jacksoniverson-ui/claude-code/stroker-desk-mount/README.md

# Stroker desk mount

A manual mount (no motor) that clamps to a desk edge and holds a caseless sleeve-style
stroker hands-free. The pivot has 15° steps, so you can angle it.

**Measured sleeve (2026-09-26): 125 mm long, 65 × 60 mm oval.** The cradle is now built in
Blender (`blender/build_cradle.py`) as an oval tube. It has no waist, so the lip-in-waist retention below
doesn't apply. The bore is 1 mm under the sleeve on both axes (64 × 59), so the sleeve
is held by squeeze, and a 6 mm lip at the back stops it being pushed through. Load it from the front.
The entrance sticks out 10 mm. The clamp, knobs and pad still come from the .scad and are unchanged.

**Print on the P1S:** open `stroker_mount_P1S_PETG.3mf`. All five parts are on one plate.
It is set up for PETG with 4 walls and 35% gyroid, with tree supports on the cradle only (under the pivot boss).
The Studio CLI slice passes: about 11 h 50 min and 256 g.
To rebuild after changing the sleeve size:

```sh
blender -b -P blender/build_cradle.py -- --len 125 --w 65 --h 60 --squeeze 1.0
blender -b -P blender/prepare_plate.py
python3 blender/make_p1s_3mf.py     # needs the canopy repo's 3mf writer; edit the paths at the top
```

*The round-sleeve notes below are for the original round-cradle .scad design.*

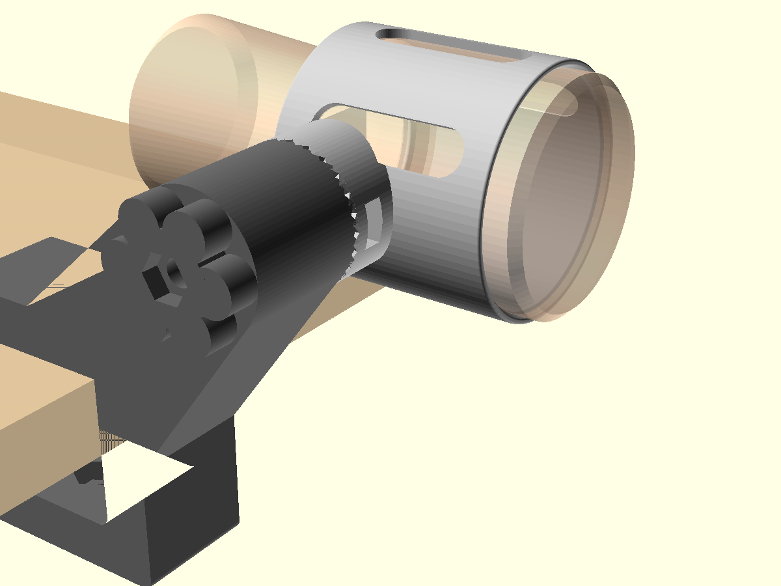
[picture p1: stroker-desk-mount/assembly.png]
assembly


## How it holds the sleeve

The sleeve has a wide front section, a narrow waist, then a flared rear. The **cradle** is a
tube that grips the wide section. A lip at the back of the tube sits in the waist:

- Pushing in drives the wide section's shoulder against the lip, so the sleeve can't be pushed through.
- Pulling out is stopped by the rear flare, which catches on the back of the lip.

To load it, squeeze the rear flare and push it through the lip from the front.
The slots let water drain and make it easier to clean.

## Parts

| File | Qty | Print orientation |
|---|-----|---|
| `clamp.stl`  | 1 | On its flat side, with the teeth facing up |
| `cradle.stl` | 1 | Standing on the lip end, with the tube upright |
| `knob.stl` | 2 | With the hex pocket facing up |
| `pad.stl` | 1 | Flat side down (optional; stick felt or rubber on it) |

Use PETG or ABS/ASA with 4+ perimeters and 30–40% infill for the clamp and cradle.
PLA works, but it creeps under constant clamping load and softens in hot water.

**Hardware:** 2× M8×60 hex bolts and 2× M8 hex nuts.

## Assembly

1. Press an M8 bolt head into each knob; a drop of CA glue holds it.
2. **Clamp screw:** drop a nut into the hex pocket inside the lower jaw. Thread a knob-bolt up
   through it from below and put the pad on the tip.
3. **Pivot:** slide a nut into the slot in the cradle boss. Mesh the cradle's teeth with the
   clamp's teeth, then pass the second knob-bolt through the clamp ear into that nut.
   To change the angle, loosen the knob, rotate the cradle, and tighten again.

## Fitting it to your sleeve (important)

The default numbers are estimates from the photos. Measure yours with calipers, or wrap a paper strip around it and divide the length by π.
Then edit the top of `stroker_desk_mount.scad`:

| Parameter  | What to measure | Default |
|---|---|---|
| `body_d` | Diameter of the wide section | 72 |
| `body_len` | Entrance face to where the waist starts | 75 |
| `waist_d`  | Diameter at the narrowest part of the waist | 55 |
| `squeeze`  | How much tighter the bore is than `body_d` | 1.0 |
| `desk_max` | Thickest desk the clamp should fit | 50 |
| `pivot_up` | Pivot height above the desktop (use a negative number to mount it under the edge) | 45 |

Before printing the full cradle, print a test ring. Set `wall = 1.6` and shorten `body_len`.

Export each part:

```sh
for p in clamp cradle knob pad; do
  openscad -D "part=\"$p\"" -o $p.stl stroker_desk_mount.scad
done
```

## Blender → Bambu Studio

`blender/prepare_plate.py` takes the STLs into Blender. It:
- repairs the meshes and checks that they are watertight,
- turns each part to its print orientation,
- lays all the parts out on a 256 mm Bambu bed (X1/P1/A1),
- exports **`stroker_mount_plate.3mf`**.

```sh
blender -b -P blender/prepare_plate.py   # re-run after changing the .scad and re-exporting the STLs
```

To print, open `stroker_mount_plate.3mf` in Bambu Studio (File → Import, or drag it in).
Then choose your printer and PETG, slice, and press **Print** to send it to the printer.
You can also send it from Bambu Handy.

Suggested slicer settings:
- 4 walls
- 35% gyroid infill
- No supports, except "tree, touching build plate" if the preview shows the cradle boss sagging

The whole plate is 256 × 197 mm. For an A1 mini, set `BED = 180` in the script; it will then refuse to build the plate,
so print the cradle and clamp as separate plates.
