jacksoniverson-ui/claude-code/stroker-desk-mount/blender/plate.png

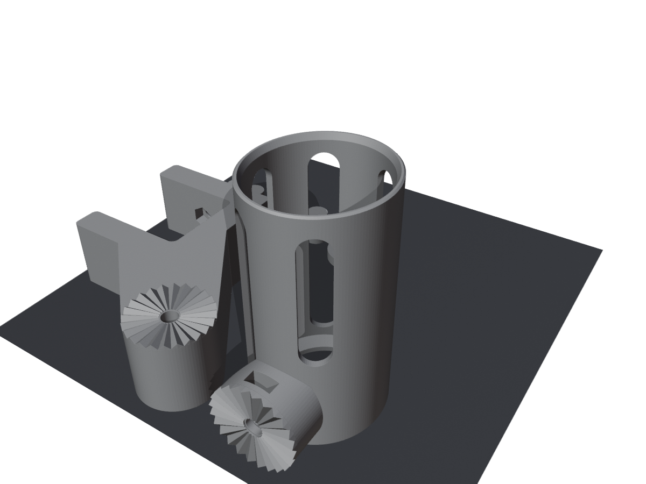
stroker-desk-mount/blender/plate.png
