jacksoniverson-ui/claude-code/stroker-desk-mount/cradle.stl

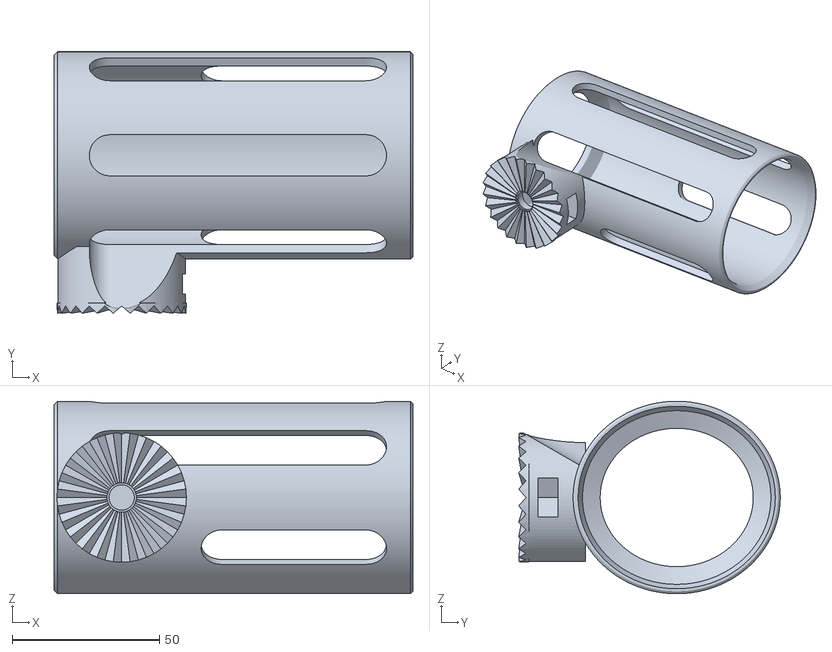
[picture p3: CAD file, 2026-09-26]
stroker-desk-mount/cradle.stl
122.0 x 88.9 x 65.4
