jacksoniverson-ui/claude-code/stroker-desk-mount/stroker_mount_P1S_PETG.3mf

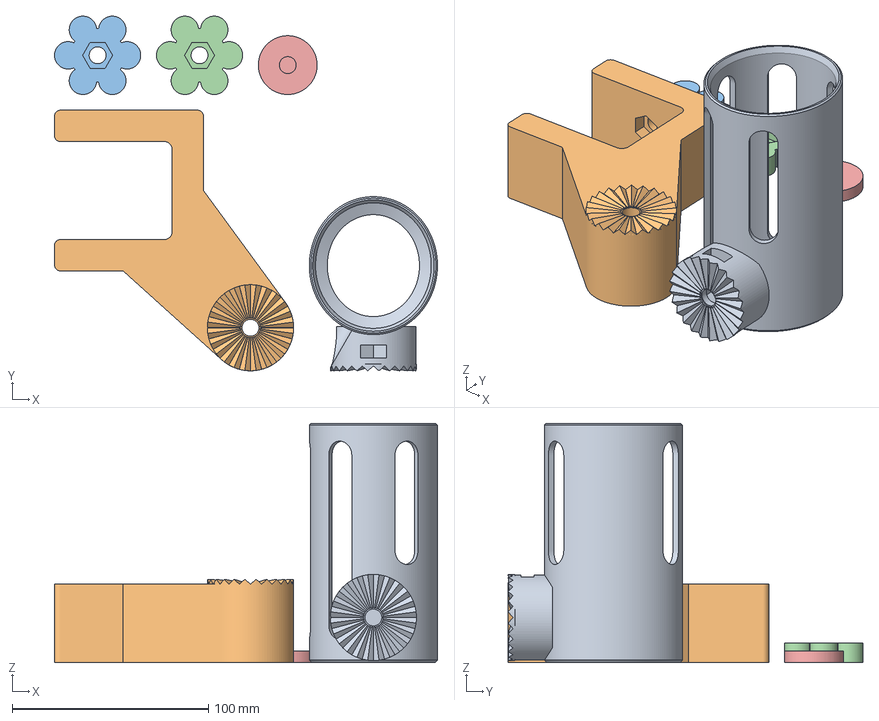
[picture p4: CAD file, 2026-09-26]
stroker-desk-mount/stroker_mount_P1S_PETG.3mf
195.4 x 181.0 x 122.0 mm
cradle
clamp
knob
knob.2
