jacksoniverson-ui/claude-code/stroker-desk-mount/pad.stl

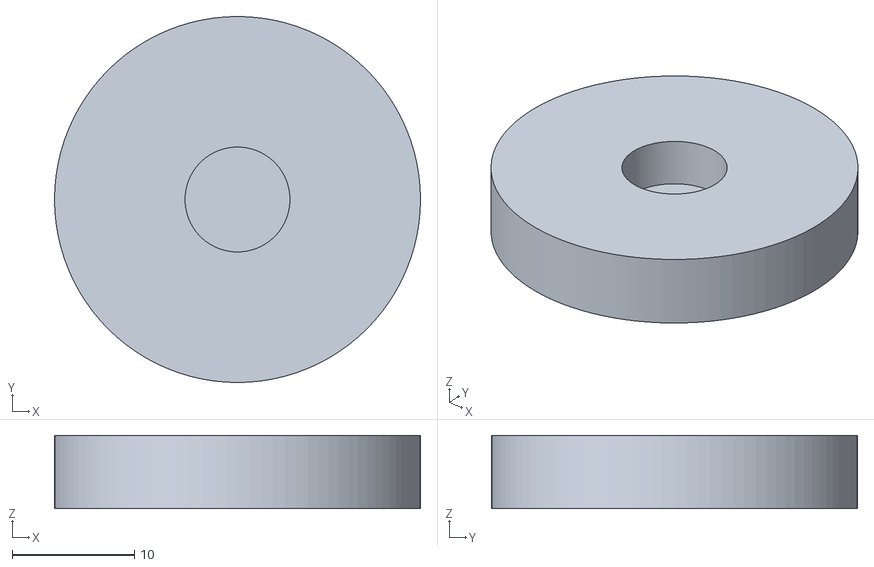
[picture p5: CAD file, 2026-09-26]
stroker-desk-mount/pad.stl
30.0 x 30.0 x 6.00
