jacksoniverson-ui/claude-code/stroker-desk-mount/clamp.stl

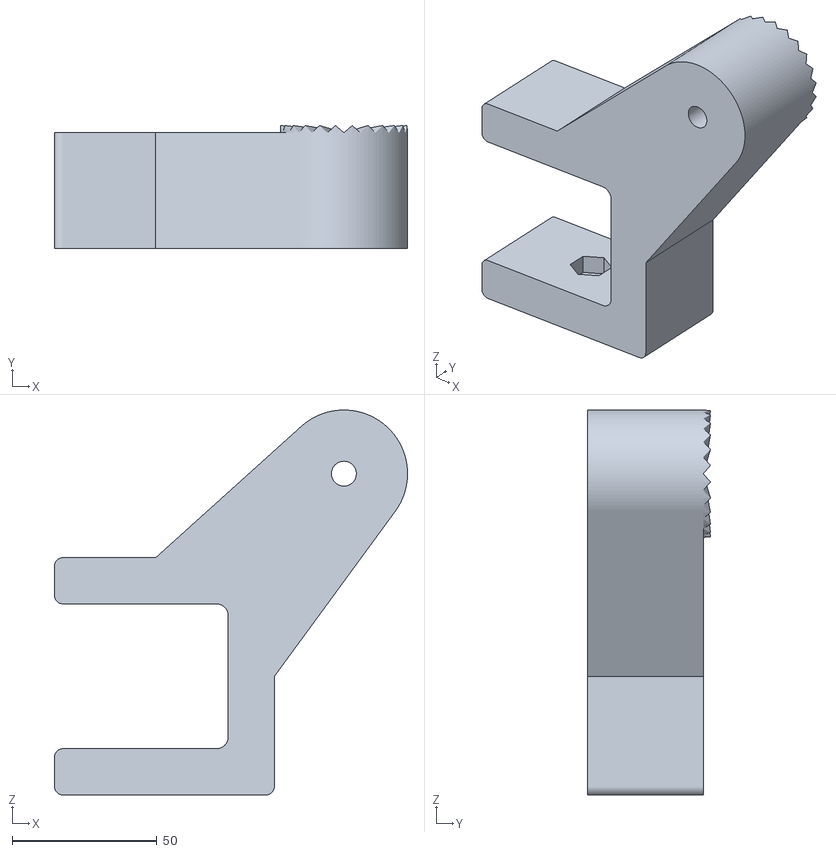
[picture p6: CAD file, 2026-09-26]
stroker-desk-mount/clamp.stl
122.0 x 42.5 x 133.0
