jacksoniverson-ui/claude-code/stroker-desk-mount/knob.stl

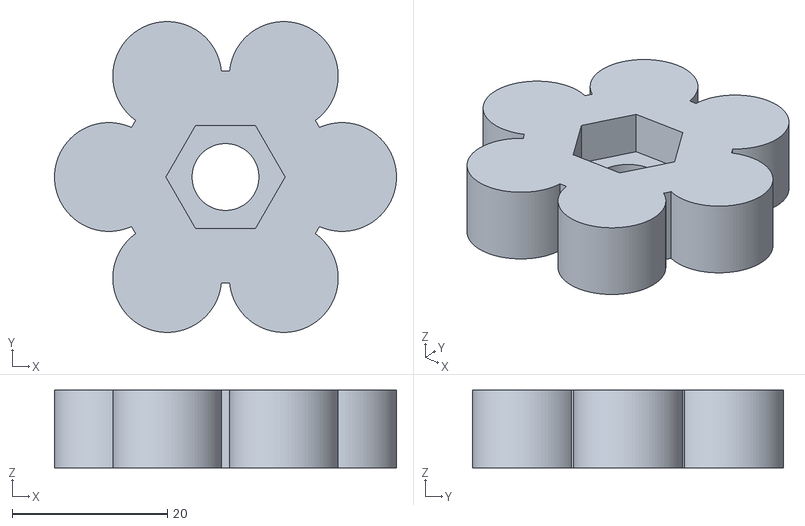
[picture p7: CAD file, 2026-09-26]
stroker-desk-mount/knob.stl
44.0 x 40.0 x 10.0
