jacksoniverson-ui/claude-code/(list of files, cad)

Other CAD files:
stroker-desk-mount/stroker_mount_plate.3mf
stroker-desk-mount/blender/stroker_mount.blend
