jacksoniverson-ui/claude-code/(commit log)

2026-09-01 Add Canopy trim room inventory tracking
    Tracks material through the trim room across four streams — A buds, B buds,
    trim and waste — so every gram weighed into a batch can be accounted for at
    the end of the shift.
    Flow: weigh a batch in, issue material to a trimmer's station, weigh out to a
    stream, weigh whatever is left back to the batch when the station closes. Per
    station, accounted = A + B + trim + waste + returned, and variance is that
    against the weight issued; a batch's variance is the sum of its stations'.
    Anything past the configurable tolerance (default 2%) is flagged in the room,
    the reports and the exports.
    Guardrails that matter for compliance:
    - Stations cannot be issued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
2026-09-26 Add parametric 3D-printable desk mount for a sleeve stroker
    OpenSCAD source plus rendered STLs: desk C-clamp with an adjustable
    Hirth-tooth pivot, a cradle whose rear lip locks into the sleeve's
    waist, M8 bolt knobs and a clamp pad.
    Claude-Session: https://claude.ai/code/session_015Pd2FV4gkg3ozLK7tU22Pm
    [clamp.stl, cradle.stl, knob.stl, pad.stl, stroker_desk_mount.scad]
2026-09-26 Add Blender plate prep and Bambu Studio 3MF
    Blender script imports the STLs, verifies they are watertight, orients
    each part for printing, packs them on a 256 mm bed and exports a 3MF
    plus a preview render and .blend scene.
    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
    [stroker_mount.blend, stroker_mount_plate.3mf]
2026-09-26 Oval cradle for measured 125x65x60 sleeve, built in Blender; P1S PETG project
    [cradle.stl, stroker_desk_mount.scad, stroker_mount.blend, stroker_mount_P1S_PETG.3mf, stroker_mount_plate.3mf]
